mojooz2/hexapod-robot/media/README.md

# Media

## Final

- `final_top_view.png` — completed six-leg robot during final integration/testing.
- `walking_demo.gif` — short README-friendly ground locomotion preview.
- `walking_demo.mp4` — higher-quality final ground walking demonstration.

## CAD

- [`cad/full_hexapod_CAD.png`](cad/full_hexapod_CAD.png) — complete hexapod CAD assembly.
- [`cad/single_leg_with_servo_CAD.png`](cad/single_leg_with_servo_CAD.png) — 3-DOF leg assembly with servo motors.
- [`cad/single_leg_without_servo_CAD.png`](cad/single_leg_without_servo_CAD.png) — custom leg parts without servo motors.
- [`cad/chassis_assembly_CAD.png`](cad/chassis_assembly_CAD.png) — central chassis CAD assembly.

The corresponding STEP models and quantities are documented in [`cad/README.md`](../cad/README.md).

## Development

The numbered photos document the progression from individual 3D-printed joints and a single 3-DOF leg through chassis, power electronics, six-leg assembly, and final integration.

`single_leg_motion.mp4` is an early motion test of a single assembled leg.
