mojooz2/hexapod-robot/cad/chassis/chassis_bottom.step

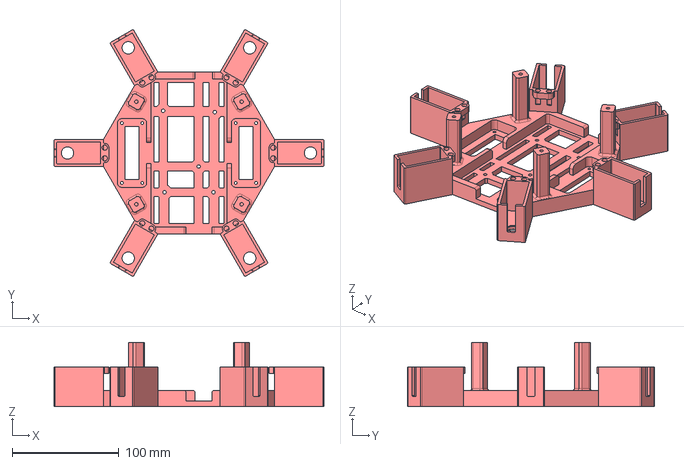
[picture p5: CAD file, 2026-10-12]
cad/chassis/chassis_bottom.step
252.4 x 230.5 x 60.0 mm
