mojooz2/hexapod-robot/cad/leg/coxa_motormount.step

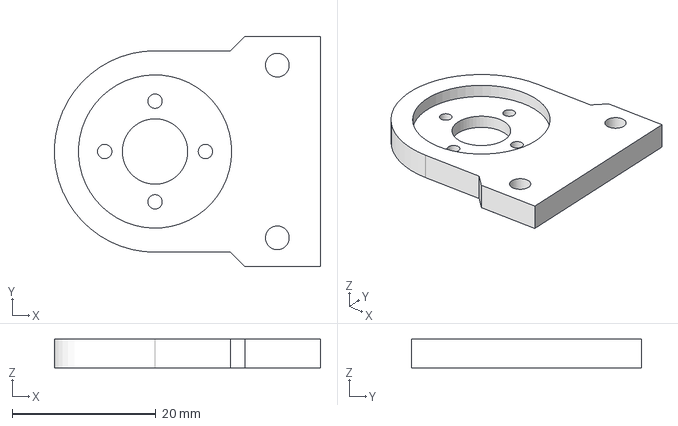
[picture p6: CAD file, 2026-10-12]
cad/leg/coxa_motormount.step
37.0 x 32.0 x 4.00 mm
