mojooz2/hexapod-robot/cad/chassis/chassis_middle.step

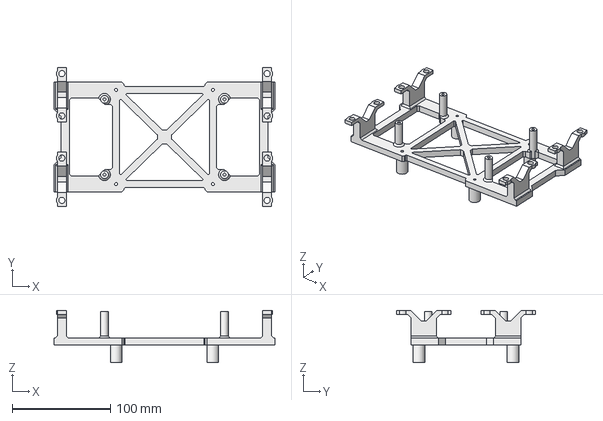
[picture p7: CAD file, 2026-10-12]
cad/chassis/chassis_middle.step
225.0 x 141.9 x 53.0 mm
