mojooz2/hexapod-robot/cad/chassis/chassis_top.step

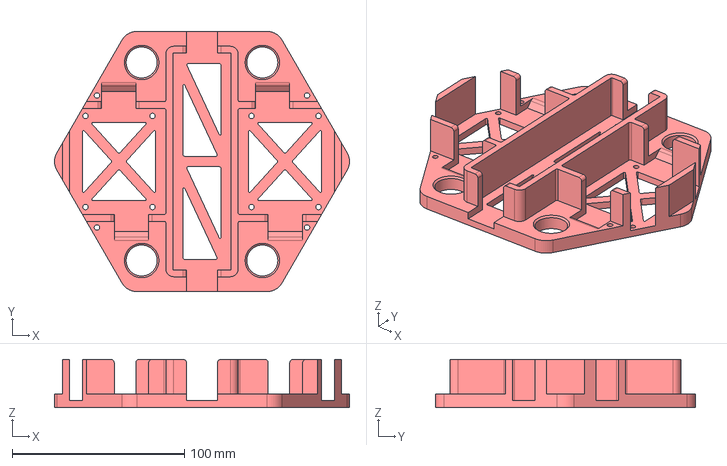
[picture p8: CAD file, 2026-10-12]
cad/chassis/chassis_top.step
171.5 x 151.2 x 28.0 mm
