mojooz2/hexapod-robot/cad/leg/common_bearingmount.step

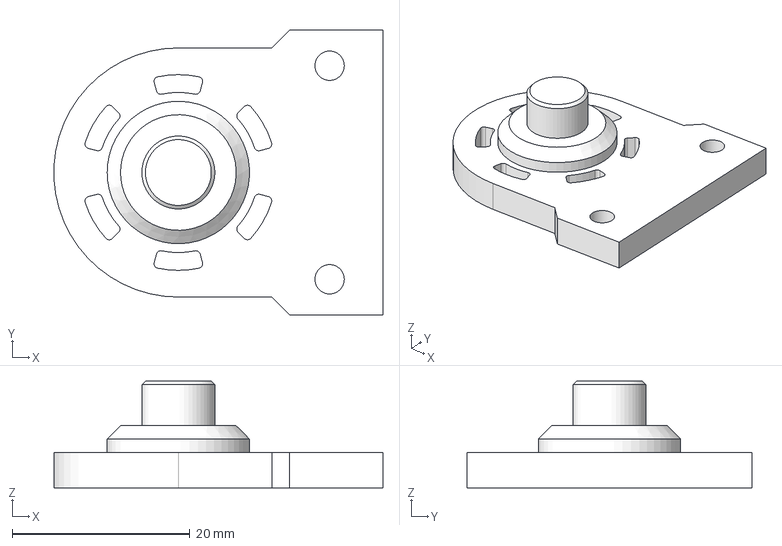
[picture p9: CAD file, 2026-10-12]
cad/leg/common_bearingmount.step
37.0 x 32.0 x 12.0 mm
