mojooz2/hexapod-robot/cad/leg/common_base.step

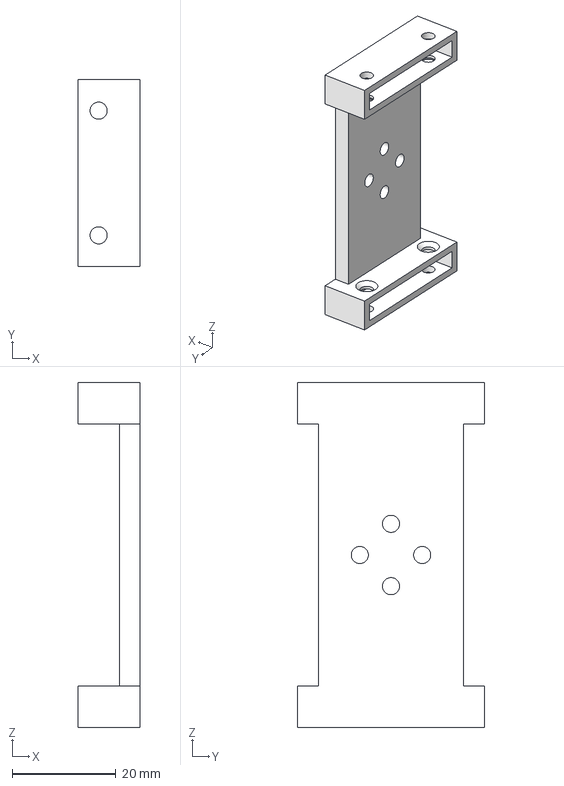
[picture p10: CAD file, 2026-10-12]
cad/leg/common_base.step
12.0 x 36.0 x 66.4 mm
