mojooz2/hexapod-robot/cad/leg/tibia_motormount.step

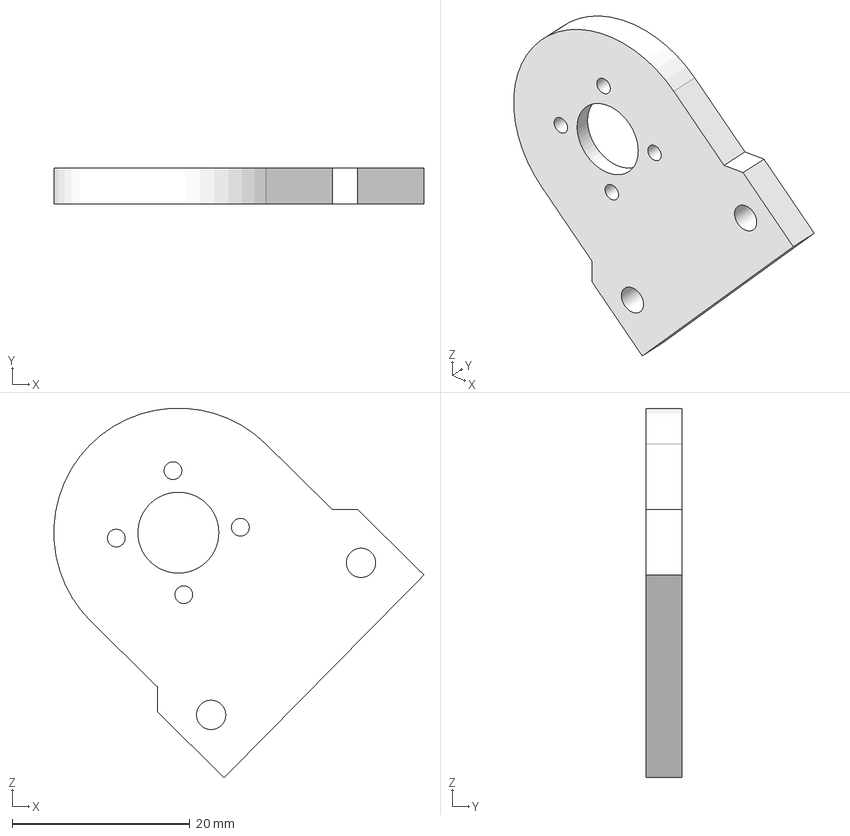
[picture p11: CAD file, 2026-10-12]
cad/leg/tibia_motormount.step
41.6 x 4.00 x 41.5 mm
