mojooz2/hexapod-robot/cad/leg/tibia_base.step

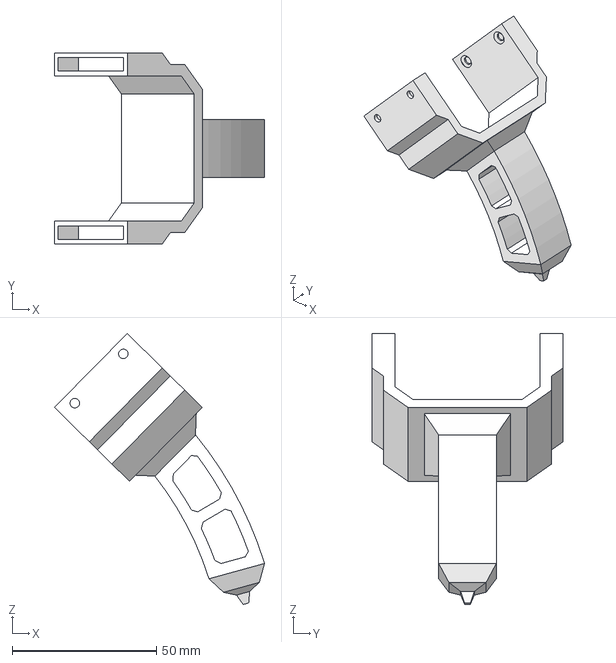
[picture p12: CAD file, 2026-10-12]
cad/leg/tibia_base.step
72.9 x 66.4 x 94.1 mm
