mojooz2/hexapod-robot/cad/leg/femur_shell.step

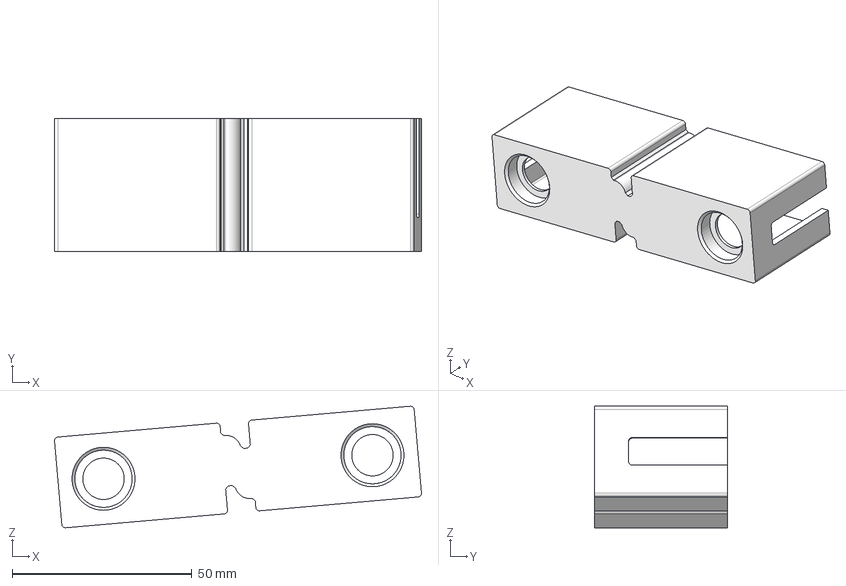
[picture p13: CAD file, 2026-10-12]
cad/leg/femur_shell.step
102.0 x 37.0 x 33.8 mm
