mojooz2/hexapod-robot/(list of files, cad)

Other CAD files:
cad/leg/femur_motormount.step
