mojooz2/hexapod-robot/(commit log)

2026-10-12 Added chassis STEP files
    [chassis_bottom.step, chassis_middle.step, chassis_top.step]
2026-10-12 Added leg STEP files
    [common_base.step, common_bearingmount.step, coxa_motormount.step, femur_motormount.step, femur_shell.step, tibia_base.step, tibia_motormount.step]
2026-10-12 Create cad folder in media
2026-10-12 Uploaded CAD screenshots to media/cad/
2026-10-12 Document mechanical CAD models, screenshots and part quantities
